tauntonme/DaisyCore/README.md

# DaisyCore
TME Signalling - Controller board with CAN bus and port for I/O Expansion modules
Contains all design input and output files for 'DaisyCore' controller PCB.
Files produced using CAD system 'EasyPC 28.0'
