tauntonme/DaisyCore/Plots/DaisyCore (Plot Report).htm

## Plot Report

Report Written: | 10:29 Friday, December 19, 2025
Project Path: | C:\EasyPC28_Projects\DaisyCore\DaisyCore.prj
Design Path: | C:\EasyPC28_Projects\DaisyCore\DaisyCore.sch
Design Title:
Created:
Last Saved: | 27/06/2023 05:39:19
Editing Time: | 74312 min
Units: | thou (precision 2)

## Device Settings

### PDF Settings

Combine Plots Yes
Use Bookmarks Yes
Component Details Yes
Symbol Details Yes
Link Net Names Yes
View PDF Yes
All Colours Black Yes
Embed Fonts Yes

## Plots Output

### PDF Output

Layer
