tauntonme/DaisyCore/Plots/DaisyCore - DaisyCore - Schematic.pdf

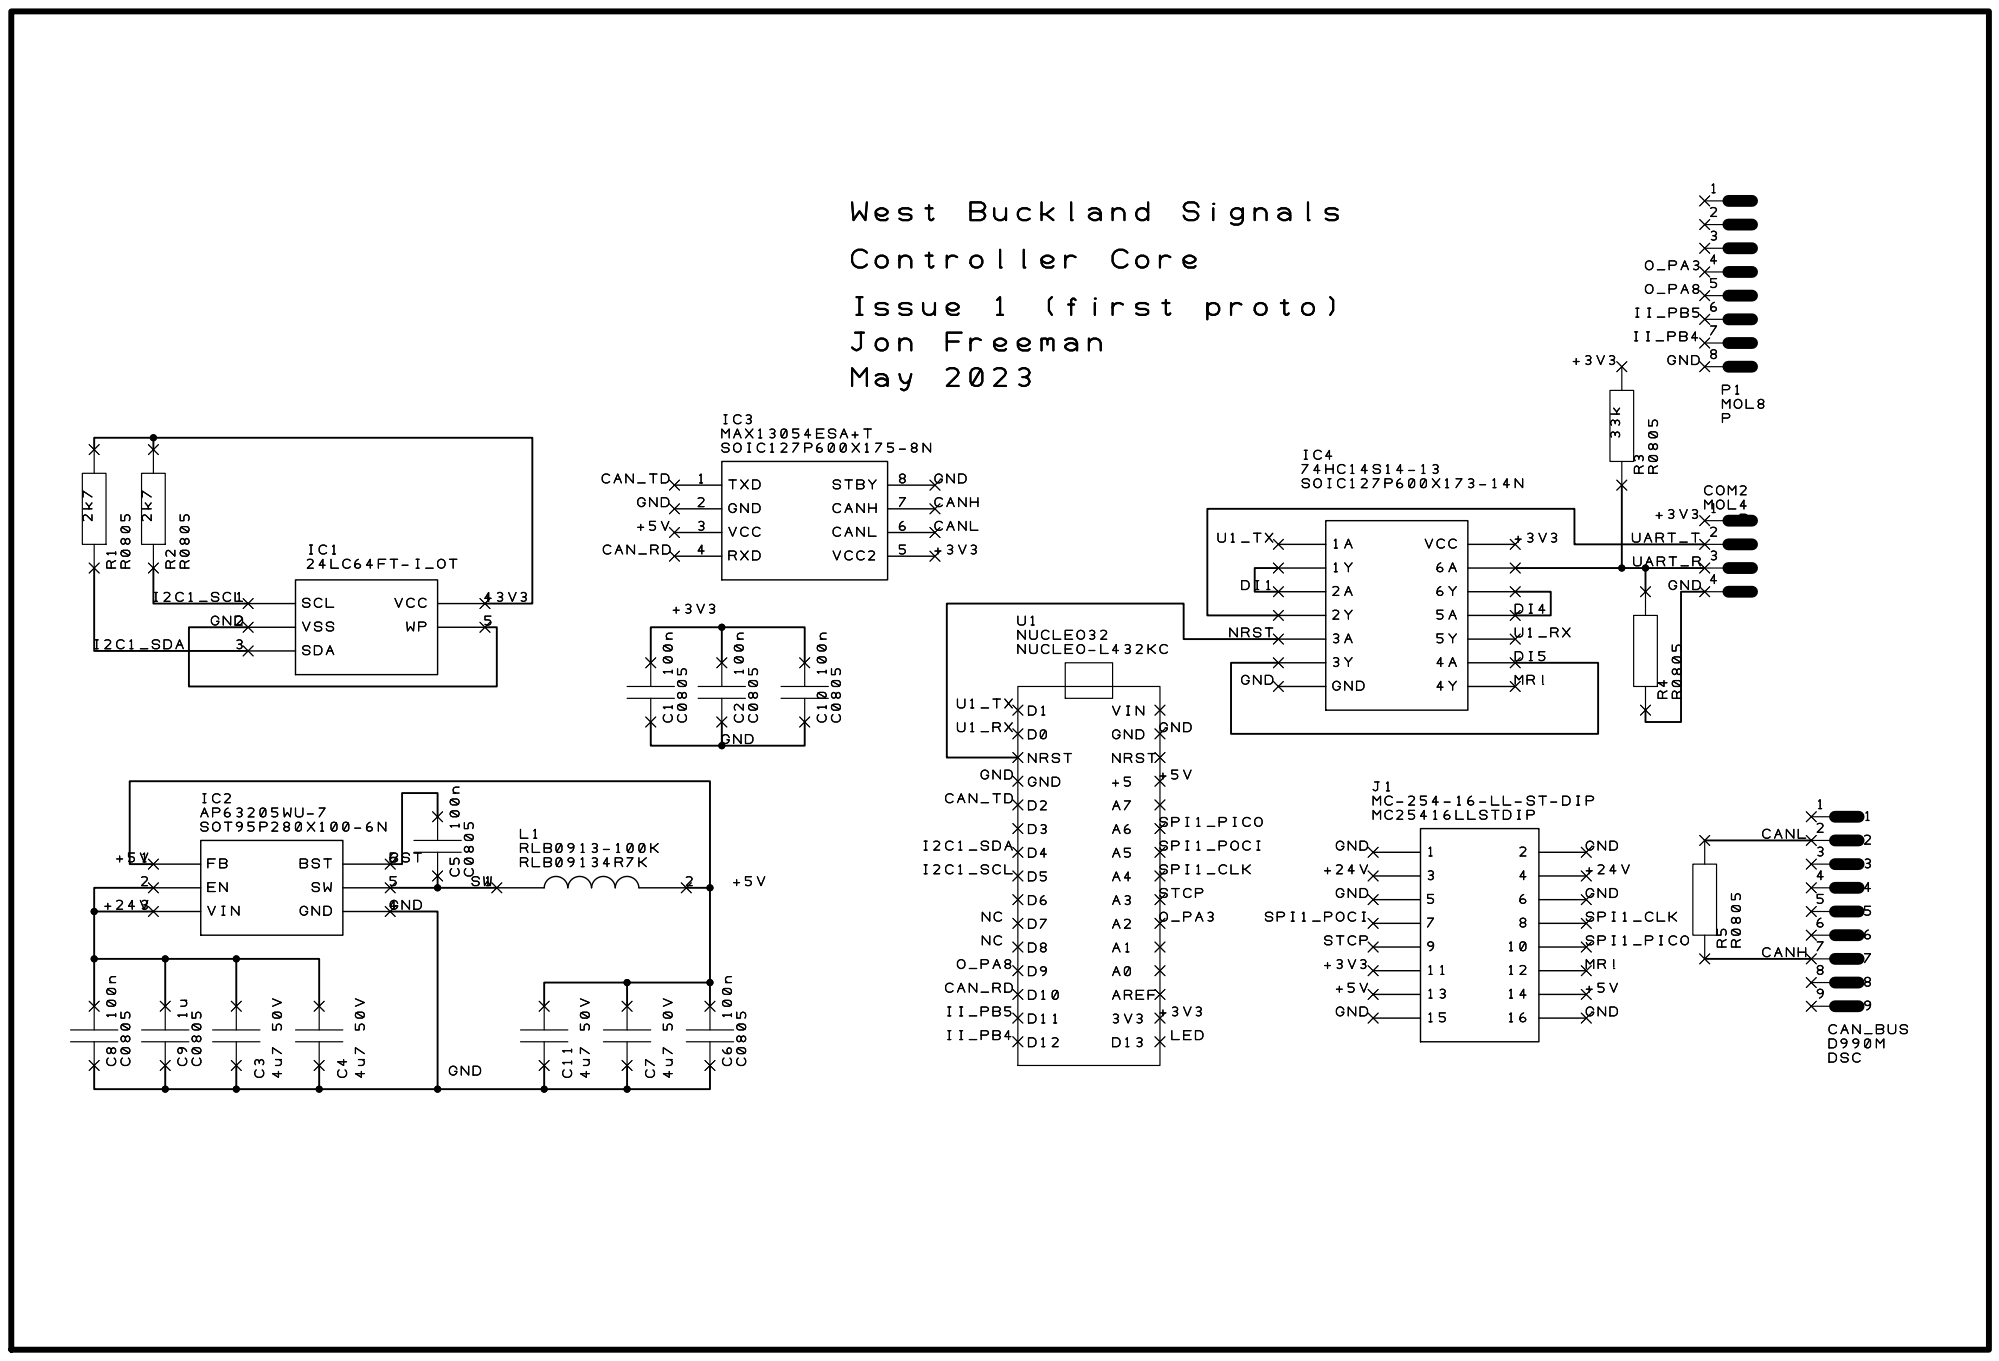
[picture p1: page 1]
