tauntonme/DaisyCore/(list of files, drawings)

Other design files:
DaisyCore.pcb
~DaisyCore.pcb
